GioeleFalbo/Robocassano27/README.md

```text
  .-=================================================================================-.
  |                                                                                   |
  |      ____  ____  ____  ____  _________   __________ ___    _   ______ ___  _____  |
  |     / __ \/ __ \/ __ )/ __ \/ ____/   | / ___/ ___//   |  / | / / __ \__ \/__  /  |
  |    / /_/ / / / / __  / / / / /   / /| | \__ \\__ \/ /| | /  |/ / / / /_/ /  / /   |
  |   / _, _/ /_/ / /_/ / /_/ / /___/ ___ |___/ /__/ / ___ |/ /|  / /_/ / __/  / /    |
  |  /_/ |_|\____/_____/\____/\____/_/  |_/____/____/_/  |_/_/ |_/\____/____/ /_/     |
  |                                                                                   |
  |        -=[  RoboCup Junior  :::  Rescue Line  :::  Cassano allo Ionio  ]=-        |
  |                                                                                   |
  |       [ ClaudeRob V45 ]     [ 111 FIX ]     [ una scatola nera alla volta ]       |
  `-=================================================================================-'
```

<p align="center">
  RoboCassano – RoboCup Junior Rescue Line
</p>

<p align="center">
  
  
  
  
  
  
</p>

<p align="center">
  <b>Un robot che segue la linea, supera ostacoli, rampe e altalena, entra nella zona di evacuazione,<br>
  porta in salvo le vittime e trova l'uscita. Da solo.</b>
</p>

---

## 🤖 Il robot

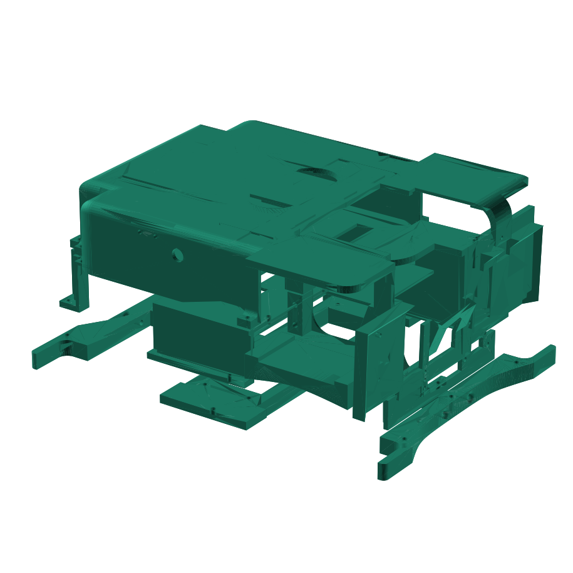
[picture p1: immagini/robot_3d.png]
Il robot RoboCassano in 3D


| | |
|---|---|
| **Cervello** | Raspberry Pi 5 |
| **Occhi** | 2 camere (linea + arena) con reti neurali **YOLO** |
| **Sensi** | Arduino Nano con 3 laser **VL53L1X**, giroscopio **BNO055**, switch |
| **Gambe** | 4 servo Feetech FS5106R a rotazione continua, uno per ruota |
| **Mani** | braccio con servo DM996 e pinza per le vittime (palline argento e nera) |
| **Misure** | 15,6 cm di larghezza, ~20 cm di lunghezza |
| **Memoria** | una **scatola nera** che registra tutto, 10 volte al secondo |
| **Corpo** | pezzi stampati in 3D su tre livelli ([`Meccanica_STL/`](Meccanica_STL/)) |
| **Energia** | LiPo 3S 11,1 V 2200 mAh e 3 convertitori buck |

<br clear="right">

<p align="center">
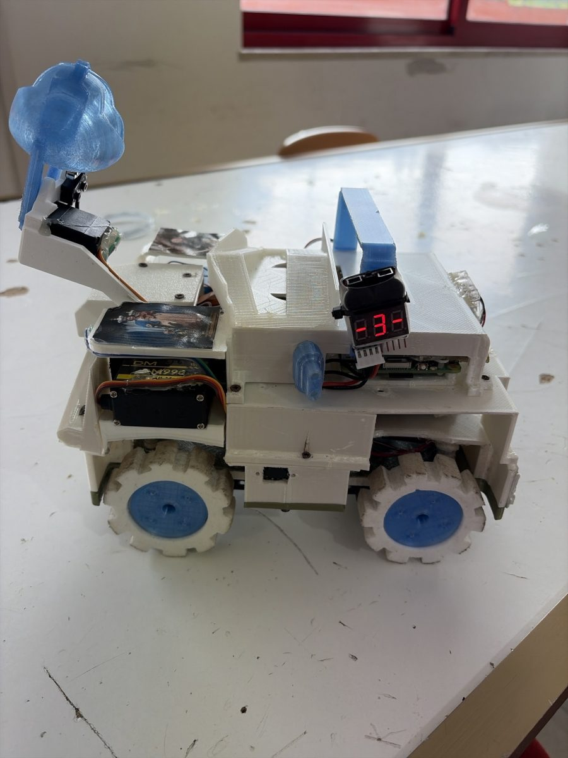
[picture p2: immagini/foto_robot/fianco.jpg]
Il robot RoboCassano visto di fianco
  
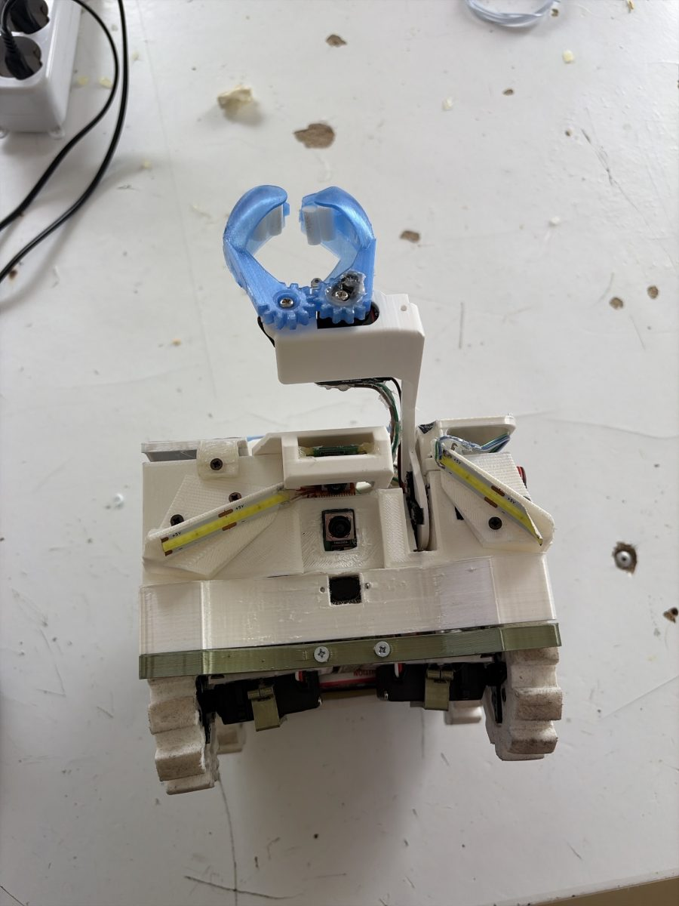
[picture p3: immagini/foto_robot/davanti_pinza.jpg]
Il robot RoboCassano visto da davanti, con la pinza
  
</p>

## 🏁 Una gara, dall'inizio alla fine

```mermaid
flowchart LR
    A([Partenza]) --> B[Seguilinea<br/>verdi, incroci,<br/>ostacolo, rampa]
    B --> C[Ingresso<br/>striscia argento]
    C --> D[Zona di evacuazione<br/>vittime nei triangoli]
    D --> E[Uscita<br/>striscia nera]
    E --> F[Altalena]
    F --> G([Linea rossa:<br/>arrivo!])
```

## 🔬 Il nostro metodo: la scatola nera

Ogni gara vera lascia una **scatola nera**: laser, giroscopio, motori, quello che vede YOLO, le foto delle camere.
Ogni correzione nasce da lì, mai da un'idea a caso:

```mermaid
flowchart LR
    R[🤖 Gara vera] --> S[📦 Scatola nera]
    S --> C[🔍 Causa fisica<br/>secondo per secondo]
    C --> M[🖥️ Riprodotta nel<br/>simulatore]
    M --> F[🛠️ Correzione<br/>FIX n]
    F --> P[✅ Prova prima/dopo]
    P --> R
```

Dal primo programma della squadra a oggi: **111 correzioni** (FIX), ognuna con il suo perché, raccontate nel
[`CHANGELOG`](ClaudeRob_V45/CHANGELOG.md).

## 👥 La squadra

| | Chi | Ruolo |
|---|---|---|
| 🧑‍🏫 | **Prof. Giovanni Vaccaro** | capo squadra: decide, controlla, approva |
| 👨‍🎓 | **Battista** | programmatore, ex modder in HEX, compositore musicale e DJ house. Gestisce la parte del seguilinea e altalena. P.s rimane sempre un tipo retro in tutto  |
| 👨‍🎓 | **Gioele** | zona di evacuazione: ingresso, vittime, uscita |
| 🛠️ | **Gabriel** | il tuttofare: disegno 3D, elettronica e meccanica del robot. Se un pezzo esiste, probabilmente l'ha disegnato, saldato o avvitato lui |
| 🚜 | **Antonio** | l'assemblatore: monta e smonta il robot con metodi da officina di campagna. Non conosce la parola "delicato", ma i pezzi alla fine stanno su. Il suo motto: *"se un pezzo non entra, non è il pezzo sbagliato: è che non hai spinto abbastanza"* |
| 📂 | **Giuseppe** | il custode delle "carte": iscrizioni, documenti di gara e tutto quello che va consegnato in ordine e in tempo |
| 🧠 | **Claude** | l'ingegnere del software: propone e prova le correzioni |
| 🔧 | **Shuri** | il collaudo: prova ogni versione e analizza le scatole nere ([chi è](Laboratorio%20Shuri/CHI_E_SHURI.md)) |

Lavoriamo con persone e agenti di intelligenza artificiale insieme, ma con una regola:
**il robot è nostro, e ogni modifica la deve saper spiegare chi la propone.**

## 📈 Sul campo

| Data | Versione | Com'è andata |
|---|---|---|
| 5 novembre 2026 | V36 | percorso completo, arrivo a 429 s |
| 6 novembre 2026 | V38 | percorso completo, arrivo a **376 s**, **3 vittime su 3**, altalena superata |
| 9 novembre 2026 | **V40** | percorso completo, arrivo a 388 s, **3 vittime su 3**, uscita in 64 s, altalena superata |
| 12 novembre 2026 | V43 | percorso completo, **3 vittime su 3**, uscita in 10 s, arrivo a 547 s (8 LoP nel seguilinea) |
| prossima prova | **V45** | 🔜 ingresso senza retromarce, cabina di pilotaggio nel terminale, una scatola nera per run |

Nel simulatore V32 la V41 completa la **pista della scuola a piastrelle** (ponte, tunnel, altalena) con 6 semi su 6 (262-311 s, 5 senza LoP) e i campi RoboCup di prova.

## 📁 Cosa c'è qui

| Cartella | Cosa c'è |
|---|---|
| [`ClaudeRob_V45/`](ClaudeRob_V45/) | il codice del robot (ultima versione). Sul Raspberry parte da solo da `~/ClaudeRob_GARA` |
| [`ClaudeRob_V44/`](ClaudeRob_V44/), [`ClaudeRob_V43/`](ClaudeRob_V43/), [`ClaudeRob_V42/`](ClaudeRob_V42/), [`ClaudeRob_V41/`](ClaudeRob_V41/), [`ClaudeRob_V40/`](ClaudeRob_V40/), [`ClaudeRob_V39/`](ClaudeRob_V39/) | le versioni precedenti, tenute per i confronti nel simulatore |
| [`ClaudeRob_Simulatore_V32/`](ClaudeRob_Simulatore_V32/) | il simulatore (Python 3 + `numpy` + `opencv-python`), con la pista della scuola **a piastrelle**: ponte sopra il tunnel, rampe di 21°, altalena, luci e ombre, cono vero del laser ([mappa](ClaudeRob_Simulatore_V32/mappa_scuola.png)) |
| [`ClaudeRob_Simulatore_V31/`](ClaudeRob_Simulatore_V31/) | il simulatore precedente, tenuto per i confronti |
| [`Strumenti_prove_Claude/`](Strumenti_prove_Claude/) | prove automatiche di porte e altalena nel simulatore |
| [`Laboratorio Shuri/`](Laboratorio%20Shuri/) | gli strumenti di Shuri: batteria di prove, analisi delle scatole nere, ultimo rapporto |
| [`ScatoleNere/`](ScatoleNere/) | le scatole nere delle gare vere e la foto dell'arena dall'alto |
| [`Meccanica_STL/`](Meccanica_STL/) | i pezzi stampati in 3D del robot (millimetri), compreso il braccio, e **`esploso_robot.html`**: il robot in 3D che si smonta (doppio clic) |
| [`Meccanica_STL/componenti/`](Meccanica_STL/componenti/) | i componenti in 3D semplificato: servo FS5106R e DM996, LiPo, buck, Arduino Nano, PCA9685, Raspberry Pi 5, relè |
| [`immagini/`](immagini/) | il banner, il robot in 3D e le [foto del robot vero](immagini/foto_robot/) |
| [`.claude/skills/anatomia/`](.claude/skills/anatomia/) | la skill **anatomia**: chiedete a Claude *"smontami il sistema dei laser"* e vi spiega ogni pezzo, nel robot e nel codice |
| [`COME_LAVORARE.md`](COME_LAVORARE.md) | **per chi entra nella squadra**: GitHub, regole delle versioni, prove nel simulatore |
| [`CLAUDE.md`](CLAUDE.md) | regole del progetto, storia delle versioni e cose da fare (lo legge Claude Code) |
| [`Raspberry/`](Raspberry/) | l'avvio del robot: all'accensione parte da solo con l'ultima versione copiata sul Raspberry |
| `Aggiorna da GitHub.command` | doppio clic sul Mac: aggiorna la cartella `02_Robotica` con l'ultima versione |

## 🚀 Provare il robot nel simulatore

```
pip3 install numpy opencv-python
cd Strumenti_prove_Claude
python3 gira.py ../ClaudeRob_V45 prova scuola_nuova 480 seme=1
```

E per vederlo muoversi nel browser:

```
cd ../ClaudeRob_Simulatore_V32
python3 crea_replay.py prova.html replay_prova.json:"Prova V45"
```

---

<p align="center">
  <sub>Fatto a Cassano allo Ionio, una scatola nera alla volta. 🖤🟩</sub>
</p>
