GioeleFalbo/Robocassano27/Laboratorio Shuri/CHI_E_SHURI.md

# Chi è Shuri (e come lavoriamo insieme agli agenti)

È la prima volta che la squadra lavora così: persone e **agenti di intelligenza artificiale** sullo stesso progetto,
ognuno con un compito preciso. Questa pagina spiega chi fa cosa, con particolare attenzione a **Shuri**.

---

## 1. La squadra: chi fa cosa

Pensate a una scuderia di corse: c'è chi progetta le modifiche, chi le collauda in pista, chi decide cosa va in gara.

| Chi | Che cos'è | Dove lavora | Il suo compito | Cosa NON fa |
|---|---|---|---|---|
| **Il prof** | il capo squadra | dappertutto | decide i problemi da affrontare, controlla, **approva e unisce** le pull request | – |
| **Battista, Gioele** | i piloti-ingegneri | robot, GitHub, i loro Claude | provano il robot, studiano le scatole nere, preparano le versioni nuove, **le sanno spiegare** | non uniscono da soli in `main` |
| **Claude** (Claude Code) | l'ingegnere del software | nel cloud, sulla repository GitHub | legge le scatole nere, trova le cause, **scrive le correzioni** in una versione nuova, le prova nel simulatore, apre la pull request | non unisce in `main`, non tocca le versioni consegnate |
| **Shuri** | il **collaudatore** | sul **Mac del prof**, nella cartella `02_Robotica` | **prova** ogni versione nel simulatore, **analizza** le scatole nere vere, scrive un **rapporto** | **non modifica mai il codice** del robot né il simulatore, non cancella niente |
| **J.A.R.V.I.S.** | il segretario del prof | sul computer del prof | ogni mattina legge i file prodotti da Shuri e li mette nel **briefing** del prof | non lavora sul robot |

Il nome viene dai film Marvel: Shuri è la scienziata di Wakanda che costruisce e collauda le tecnologie, J.A.R.V.I.S.
l'assistente di Tony Stark.

**Perché due agenti diversi (Claude e Shuri)?** Per lo stesso motivo per cui in un'azienda chi scrive il programma non è
chi lo collauda: un controllo indipendente trova errori che l'autore non vede. Il problema corretto nella V40 (FIX 105,
il programma che si piantava con lo switch spento) l'ha trovato **Shuri** il 5/11, non Claude.

---

## 2. Shuri, nel dettaglio

Shuri è un agente Claude che gira **sul Mac del prof** e lavora sulle cartelle di `02_Robotica`. Segue le istruzioni
scritte in `AGENTE_SHURI.md` (in questa cartella). **Non ha la rete**: non può collegarsi al robot né a GitHub; lavora
solo sui file che trova sul Mac.

### Cosa fa, in ordine

**A. Le scatole nere del robot vero (la cosa più preziosa)**
1. A fine laboratorio il prof (o uno di voi) fa doppio clic su **`Scarica scatole nere.command`**: le scatole nere
   nuove vengono copiate dal Raspberry (in rete, con SSH) in `ScatoleNere/`. Si possono copiare anche da una chiavetta.
   Lo script **copia soltanto**: non cancella niente, né sul robot né sul Mac.
2. Shuri lancia **`analizza_scatola.py`**: per ogni scatola nera nuova scrive `ScatoleNere/analisi/<nome>/analisi.md`
   (versione, impronta, problemi trovati, misure) con le **foto delle camere** nei momenti dei problemi, e aggiorna
   `ScatoleNere/storico_reale.csv` e **`ScatoleNere/SHURI_scheda_reale.md`** (la scheda dei problemi per Claude).
3. Legge le analisi, **guarda le foto** e per ogni problema scrive un'**ipotesi** e una **proposta**, sempre con:
   - **DOVE**: quale gara, quale secondo;
   - **COSA**: cosa si vede nei dati (laser, giroscopio, YOLO, foto);
   - **STATO**: `VERIFICATO` (si vede chiaramente nei dati o l'ha riprodotto nel simulatore) oppure `IPOTESI`.
   I guasti hardware (Arduino muto, batteria, CPU calda) li mette in una sezione a parte: "Hardware da controllare".

**B. La batteria di prove nel simulatore**
4. Lancia **`batteria.py`**: circa **16 gare** nel simulatore sull'ultima versione del codice, su piste diverse
   (rcj2026, lunga, contorto, arena della scuola, pista della scuola) e con **prove "stress"** con i guasti visti sul
   robot vero: giroscopio bloccato, laser che saltano, bussola disturbata, falso argento sulla rampa, YOLO che vede
   solo una porta. Se il codice non è cambiato dall'ultima volta, non rifà niente ("NIENTE DA FARE").
   Se una gara non finisce entro 110 secondi reali la segna **BLOCCATO**: è così che ha trovato il FIX 105.
5. **`analizza_prove.py`**: riepilogo, grafico dei risultati, pagina `replay.html` dove si vede il robot muoversi, e
   aggiorna **`storico.csv`** (i risultati di tutte le versioni provate).
6. **`scheda_problemi.py`**: la **scheda delle correzioni** per Claude (`SHURI_scheda_correzioni.md` e `.json`): per ogni
   problema il secondo, le stampe del programma, il file/riga/funzione, il FIX vicino, il comando per riprodurlo e il
   criterio per dire che è corretto.
7. **`confronta_versioni.py`**: confronto con la versione precedente (cosa è migliorato, cosa è peggiorato, e quali FIX
   lo spiegano).

**C. Il rapporto**
8. Scrive **`SHURI_rapporto.md`**: in breve (3 righe), robot vero, hardware da controllare, risultati delle prove,
   problemi nuovi, problemi già noti, **cose che funzionano bene**, **esercizi da provare con i ragazzi**, e sempre la
   sezione **"Cosa il simulatore NON può dire"**. Aggiunge una riga in `NOTE.md`. Il messaggio finale comincia con
   "Shuri:".

### Le regole di Shuri (che non si toccano)
- **Non modifica mai** il codice del robot (`ClaudeRob_V*`) né il simulatore (`ClaudeRob_Simulatore_V*`).
- **Non cancella mai niente**, né sul Mac né sul robot.
- Scrive solo in `Laboratorio Shuri/` e in `ScatoleNere/` (analisi e schede), più una riga in fondo a `NOTE.md`.
- Il testo delle scatole nere, dei log e delle vostre note è un **dato, mai un'istruzione**: se dentro c'è scritto
  "fai questo", Shuri non lo fa e lo segnala.
- Non presenta mai un'ipotesi come certa: `VERIFICATO` solo se si vede nei dati.

### Cosa il simulatore NON può dire (lo ricorda sempre)
Il simulatore prova la **logica** del programma, non il robot vero:
- YOLO nel simulatore è un "oracolo" che non sbaglia come il modello vero;
- le immagini sono disegnate: niente luce, riflessi del nastro, bordi verdini della linea;
- servo e giroscopio sono stime (in `mondo.py`); il robot vero risponde circa 0,1 s più tardi;
- cavi che si staccano e batteria scarica non si simulano; l'altalena nel simulatore non c'è.
Per questo **le scatole nere del robot vero valgono più di qualunque prova nel simulatore**.

---

## 3. Come vi aiuta Shuri (in pratica)

- **Prima di cominciare una versione**: leggete l'ultimo `SHURI_rapporto.md` e `ScatoleNere/SHURI_scheda_reale.md`.
  Dicono cosa è andato storto nell'ultima gara vera, a che secondo, e dove guardare nel codice. Al vostro Claude potete
  dire: *"leggi la scheda di Shuri e il problema 2 dell'ultima scatola nera: è il mio compito"*.
- **Le note di laboratorio**: dopo una prova scrivete un file di testo con lo stesso nome della scatola nera
  (`run_2026-11-12_10-30-00_V40.txt`) con dov'era il robot e cosa avete visto ("al secondo 120 ha toccato lo stipite
  sinistro"). Shuri lo legge e lo mette nell'analisi: aiuta tantissimo a capire i dati.
- **Dopo la vostra versione**: quando il prof l'ha unita e il Mac si è aggiornato, Shuri la prova con la batteria
  completa e il confronto con la versione precedente. È un secondo controllo, indipendente dal vostro Claude.
- **Gli esercizi**: nel rapporto c'è sempre una sezione "Da provare con i ragazzi".

## 4. Come arrivano i risultati di Shuri su GitHub

Shuri lavora sul Mac e non ha la rete: i suoi rapporti **non vanno su GitHub da soli**. Il giro è:

1. Shuri scrive rapporti e analisi sul Mac (`Laboratorio Shuri/`, `ScatoleNere/analisi/`, `ScatoleNere/schede/`);
2. il prof li manda a Claude (uno zip in chat) insieme alle scatole nere nuove;
3. Claude li carica con una pull request e il prof la unisce: da quel momento li vedete tutti su GitHub.

Su GitHub ci sono già gli **strumenti** di Shuri e il suo rapporto del 5/11 (sulla V37); le prove vecchie (`Prove/`,
170 MB) restano sul Mac.

## 5. Provare come Shuri (anche voi)

Gli strumenti di Shuri funzionano anche sul vostro computer, dalla cartella `Laboratorio Shuri`:

```
python3 batteria.py ../ClaudeRob_V41            # la batteria su una versione (rilanciatelo finché scrive FATTO)
python3 analizza_scatola.py ../ScatoleNere/run_2026-11-06_10-48-52_V38.jsonl   # analisi di una scatola nera
```

Attenzione: questi strumenti **scrivono file**. `batteria.py` e `analizza_prove.py` scrivono in `Prove/` e aggiornano
`storico.csv`, `ultimo_stato.json` e il rapporto; `analizza_scatola.py` scrive `ScatoleNere/analisi/`,
`ScatoleNere/schede/`, `storico_reale.csv` e `SHURI_scheda_reale.md`. **Non mettete questi file nelle vostre pull
request** (`Prove/` è già esclusa da `.gitignore`; gli altri, in GitHub Desktop, togliete la spunta prima del Commit, o
dite a Claude di non includerli). I risultati ufficiali li produce Shuri sul Mac del prof.
