GioeleFalbo/Robocassano27/ClaudeRob_Simulatore_V32/mappa_scuola.png

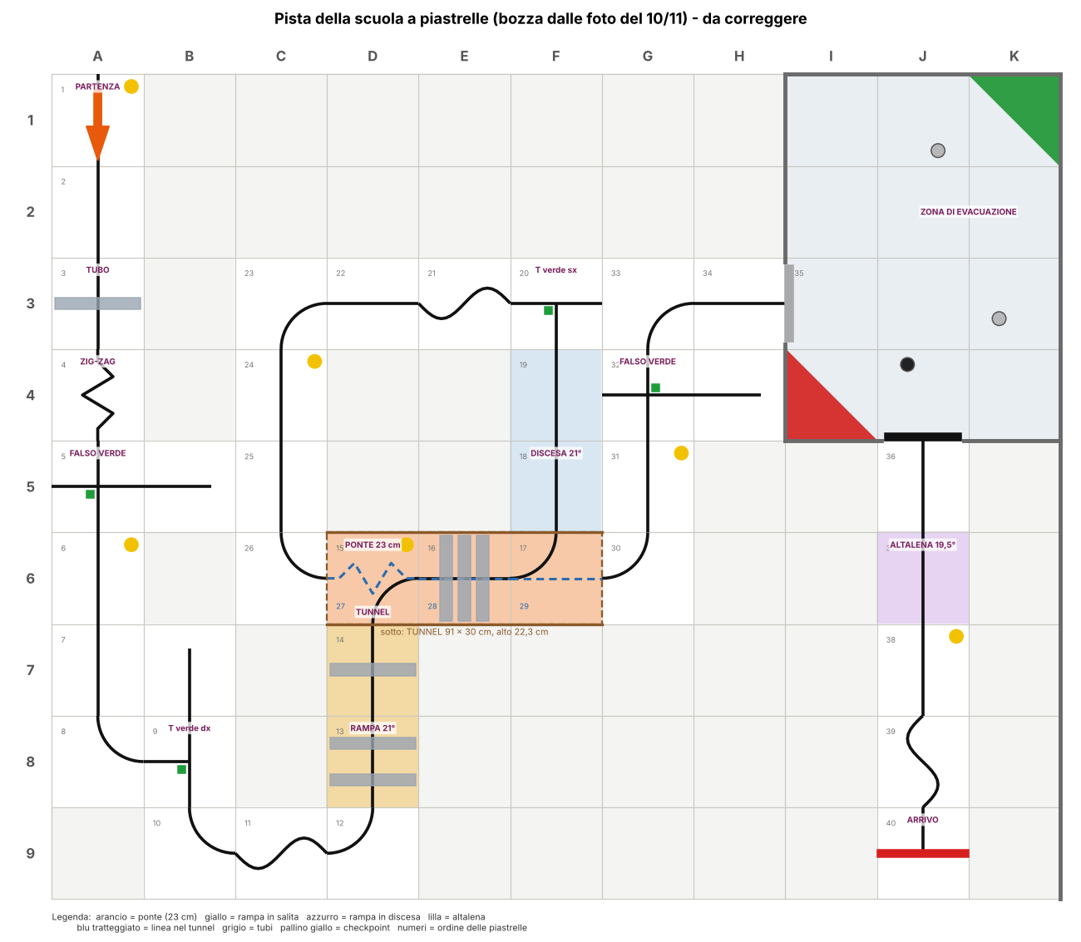
ClaudeRob_Simulatore_V32/mappa_scuola.png
