GioeleFalbo/Robocassano27/immagini/foto_robot/fianco_elettronica.jpg

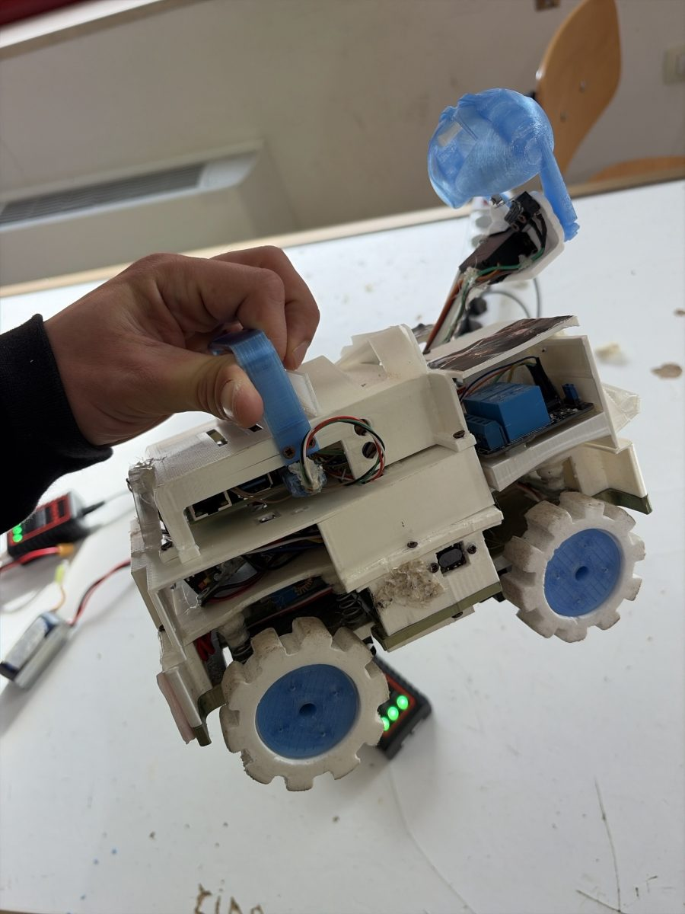
immagini/foto_robot/fianco_elettronica.jpg
