GioeleFalbo/Robocassano27/immagini/foto_robot/sotto.jpg

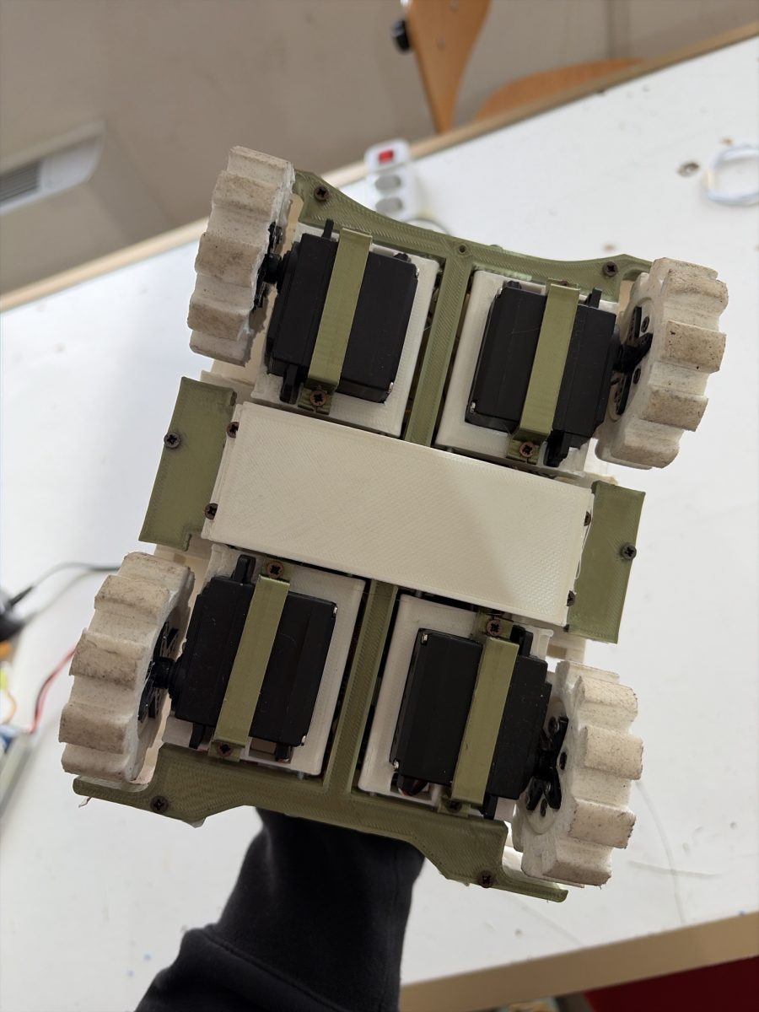
immagini/foto_robot/sotto.jpg
