GioeleFalbo/Robocassano27/ScatoleNere/arena_dall_alto_2026-11-05.jpg

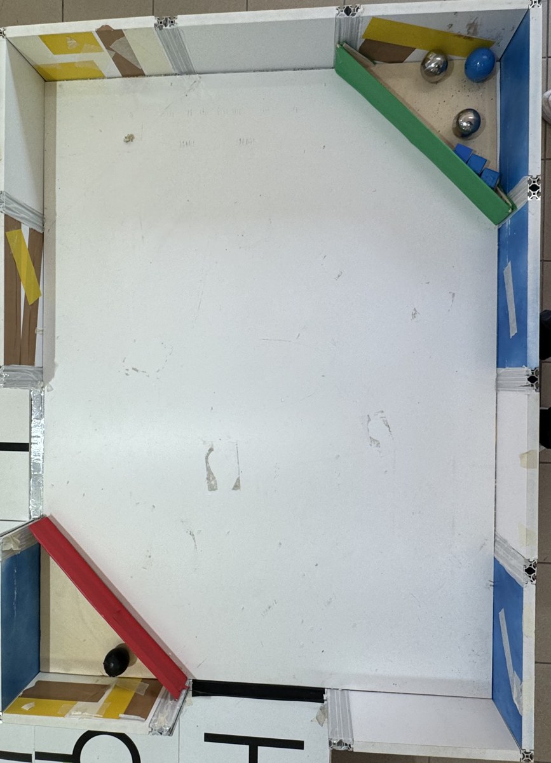
ScatoleNere/arena_dall_alto_2026-11-05.jpg
