GioeleFalbo/Robocassano27/ClaudeRob_V45/cruscotto/robot.stl

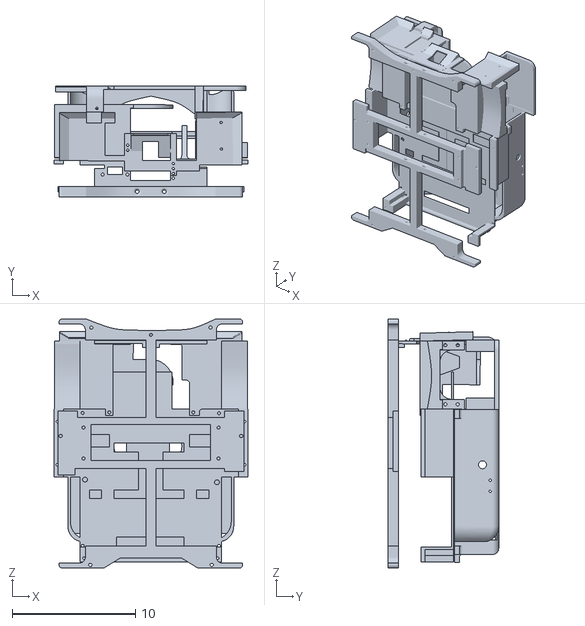
[picture p8: CAD file, 2026-11-08]
ClaudeRob_V45/cruscotto/robot.stl
15.7 x 8.96 x 20.2
