GioeleFalbo/Robocassano27/Meccanica_STL/BiSwitch.stl

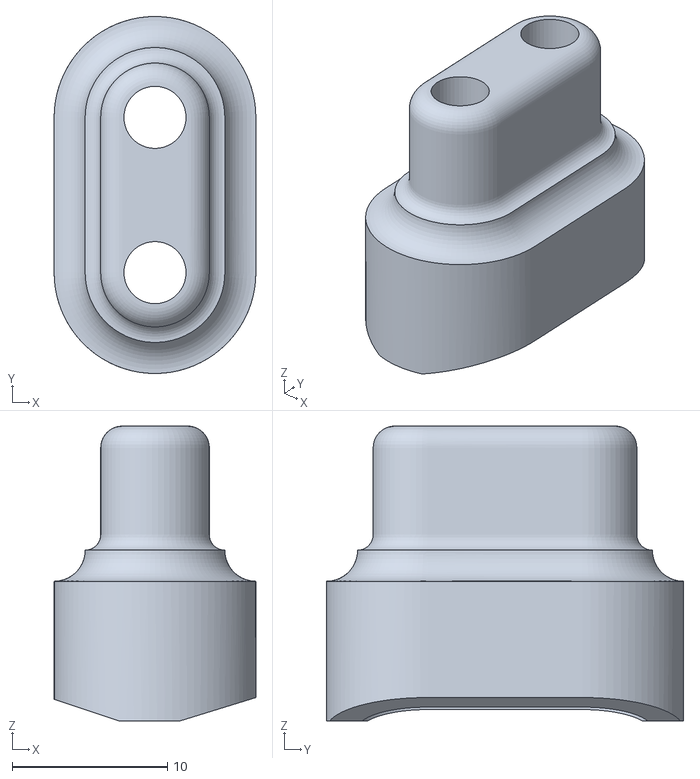
[picture p9: CAD file, 2026-11-12]
Meccanica_STL/BiSwitch.stl
13.0 x 23.0 x 19.0
