GioeleFalbo/Robocassano27/Meccanica_STL/componenti/Raspberry_Pi_5.stl

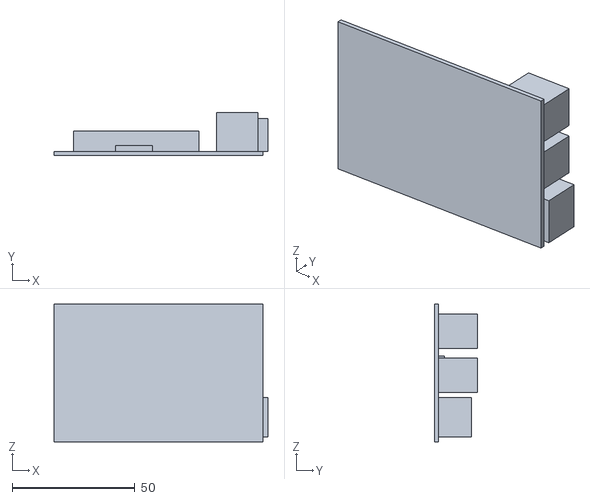
[picture p10: CAD file, 2026-11-10]
Meccanica_STL/componenti/Raspberry_Pi_5.stl
87.0 x 17.6 x 56.0
