GioeleFalbo/Robocassano27/Meccanica_STL/componenti/LiPo_Zeee_3S_2200.stl

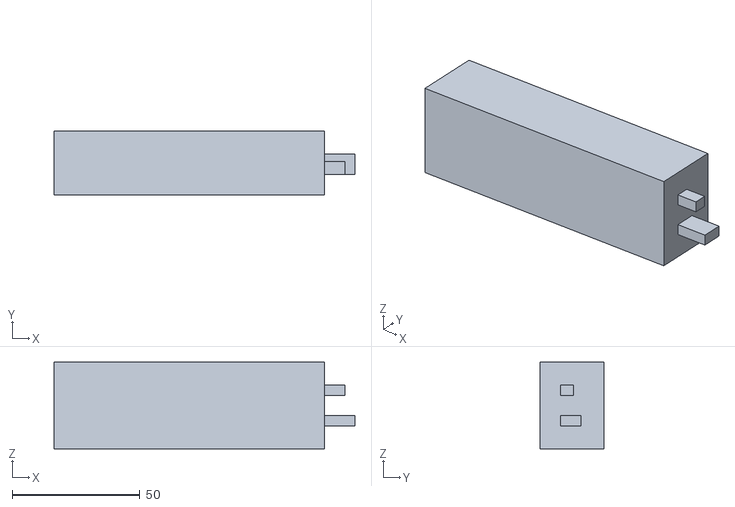
[picture p11: CAD file, 2026-11-10]
Meccanica_STL/componenti/LiPo_Zeee_3S_2200.stl
118.0 x 25.0 x 34.0
