GioeleFalbo/Robocassano27/Meccanica_STL/PinzaParteDxSfera.stl

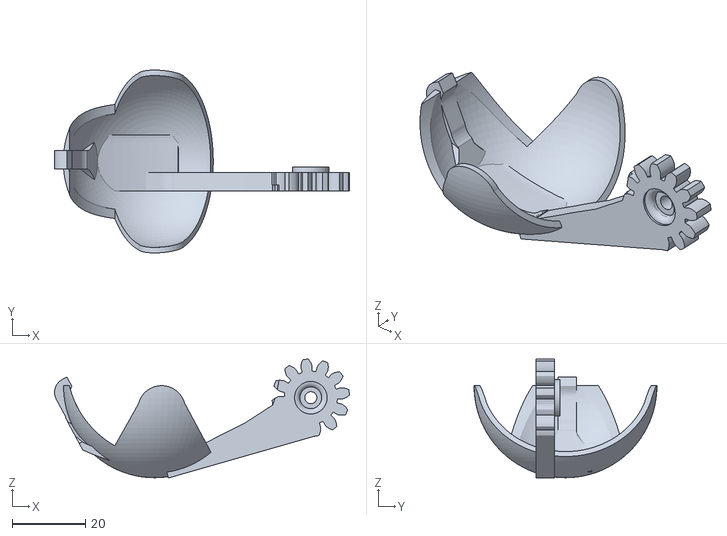
[picture p12: CAD file, 2026-11-12]
Meccanica_STL/PinzaParteDxSfera.stl
80.7 x 50.0 x 32.5
