GioeleFalbo/Robocassano27/Meccanica_STL/componenti/PCA9685_16canali.stl

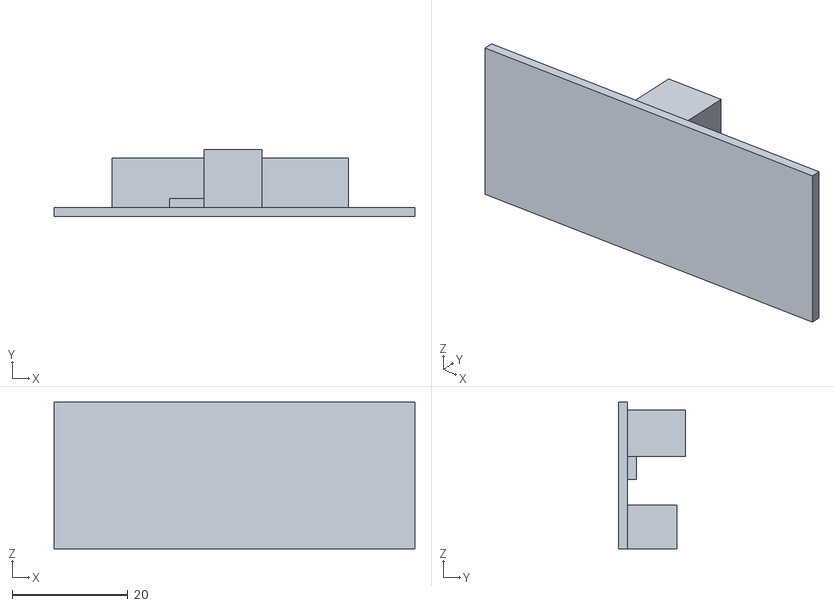
[picture p13: CAD file, 2026-11-10]
Meccanica_STL/componenti/PCA9685_16canali.stl
62.5 x 11.6 x 25.4
