GioeleFalbo/Robocassano27/Meccanica_STL/PinzaParteSxSfera.stl

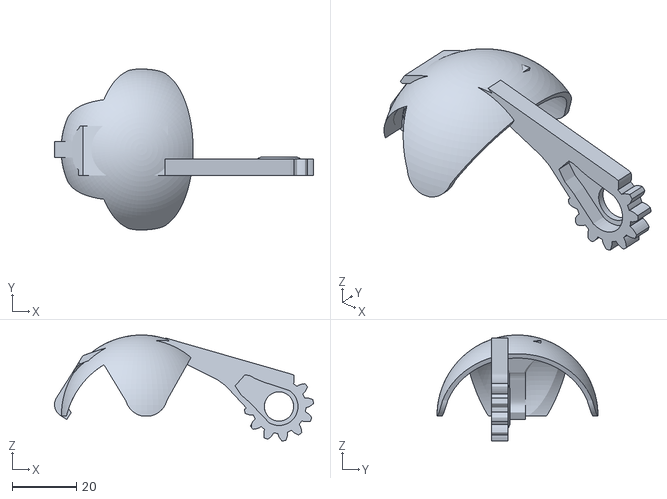
[picture p14: CAD file, 2026-11-12]
Meccanica_STL/PinzaParteSxSfera.stl
80.4 x 50.0 x 32.9
