GioeleFalbo/Robocassano27/Meccanica_STL/Braccio.stl

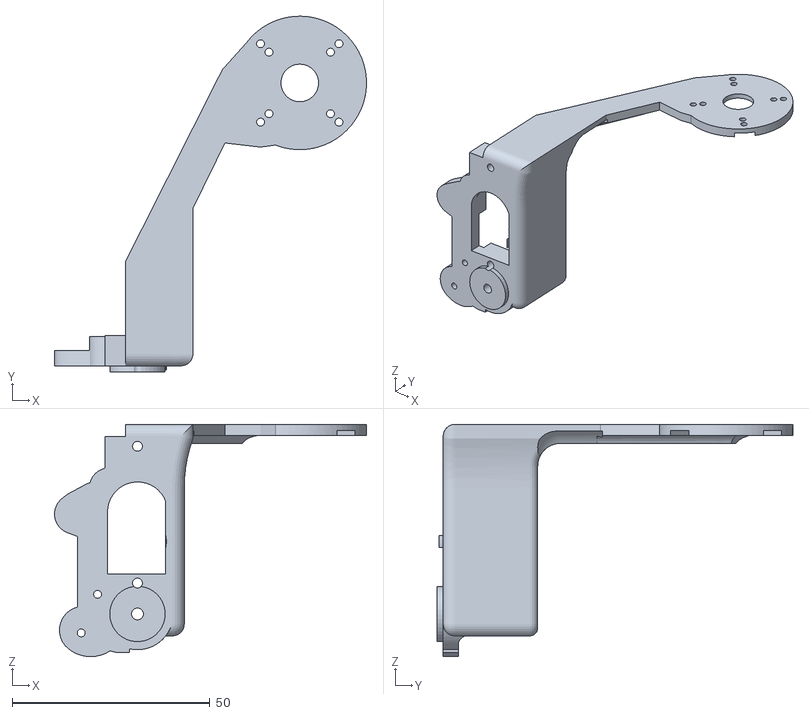
[picture p15: CAD file, 2026-11-10]
Meccanica_STL/Braccio.stl
78.8 x 89.8 x 58.7
