GioeleFalbo/Robocassano27/Meccanica_STL/componenti/Rele_2_canali.stl

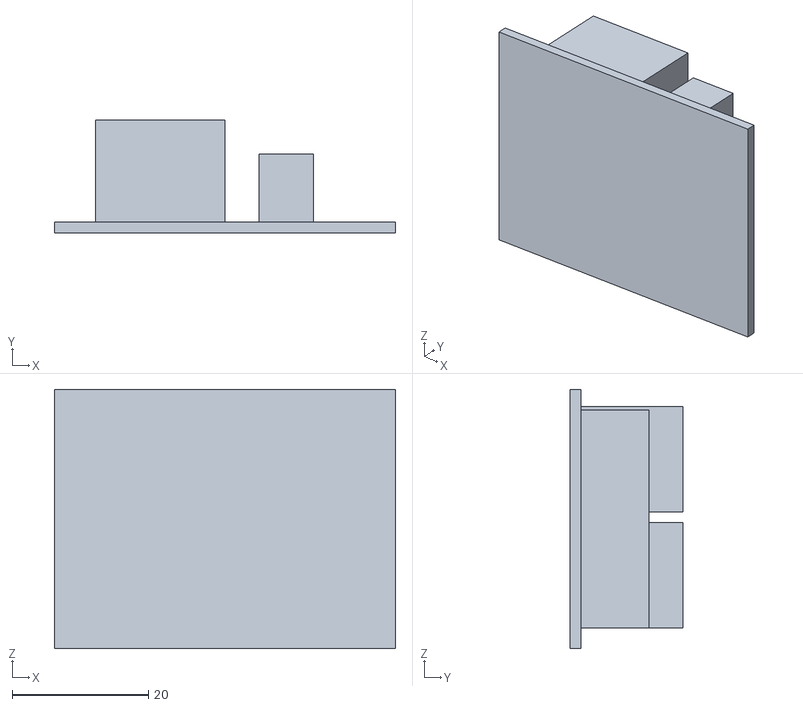
[picture p16: CAD file, 2026-11-10]
Meccanica_STL/componenti/Rele_2_canali.stl
50.0 x 16.6 x 38.0
