GioeleFalbo/Robocassano27/Meccanica_STL/componenti/Servo_DM996.stl

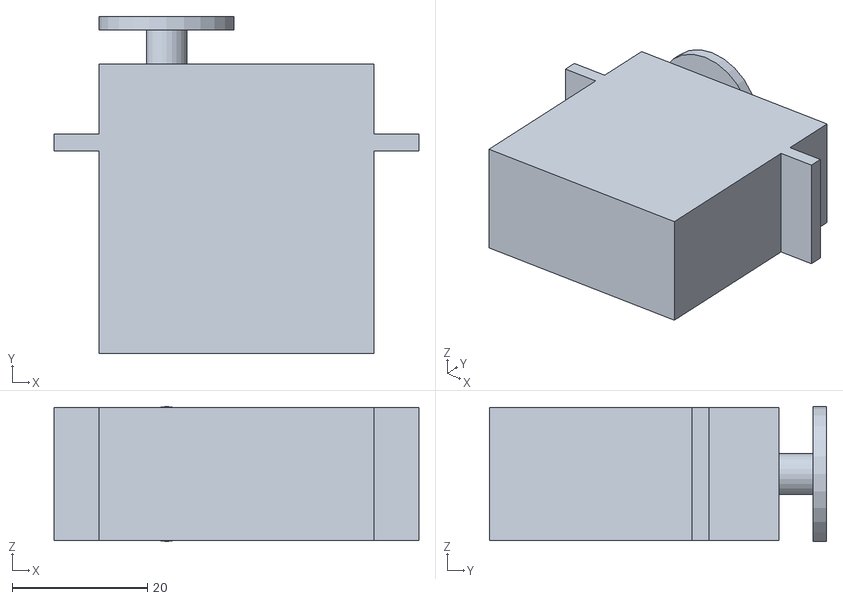
[picture p17: CAD file, 2026-11-10]
Meccanica_STL/componenti/Servo_DM996.stl
54.0 x 49.9 x 20.0
