GioeleFalbo/Robocassano27/Meccanica_STL/SupportoPinzaWebcam_1.stl

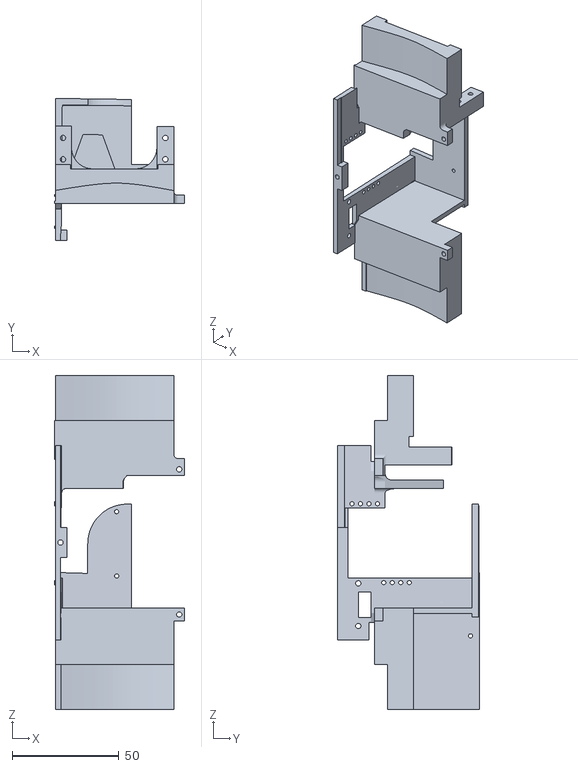
[picture p18: CAD file, 2026-11-08]
Meccanica_STL/SupportoPinzaWebcam_1.stl
61.0 x 66.7 x 156.6
