GioeleFalbo/Robocassano27/Meccanica_STL/componenti/Buck_DCDC.stl

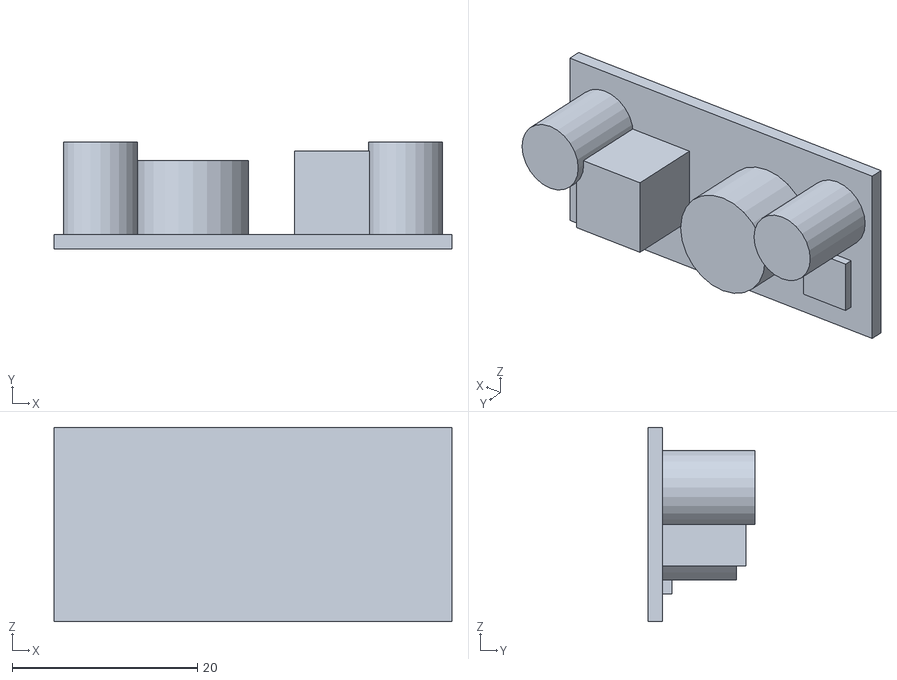
[picture p19: CAD file, 2026-11-10]
Meccanica_STL/componenti/Buck_DCDC.stl
43.0 x 11.6 x 21.0
