GioeleFalbo/Robocassano27/Meccanica_STL/CoperturaAlta.stl

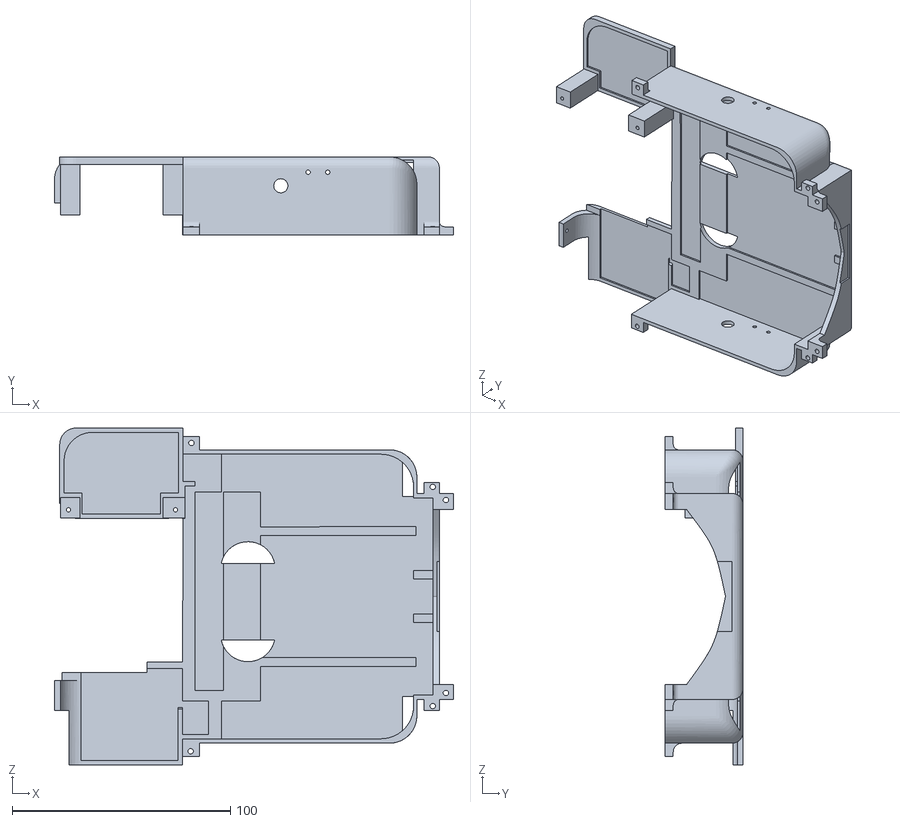
[picture p20: CAD file, 2026-11-08]
Meccanica_STL/CoperturaAlta.stl
182.9 x 35.8 x 154.4
