GioeleFalbo/Robocassano27/Meccanica_STL/componenti/Servo_FS5106R.stl

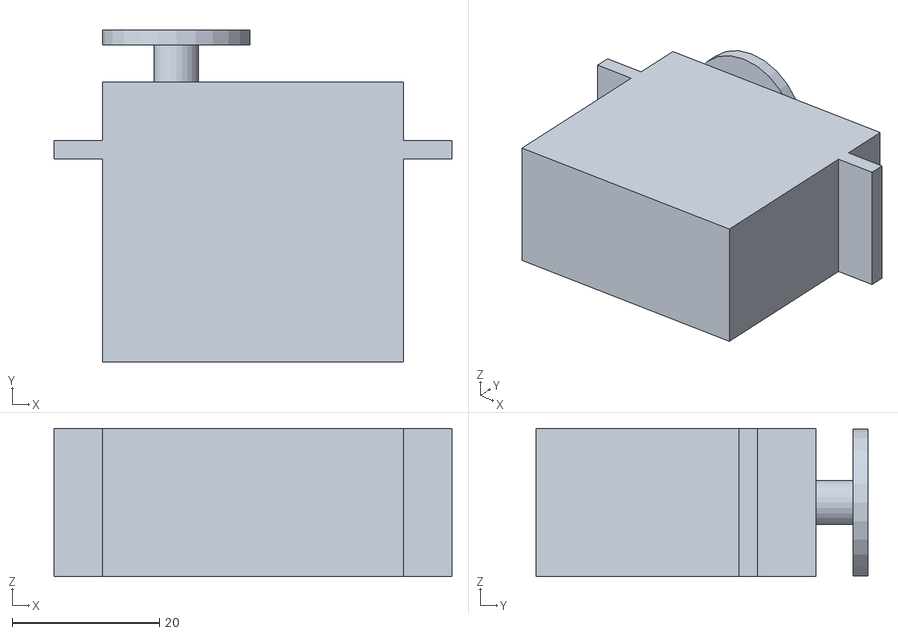
[picture p21: CAD file, 2026-11-10]
Meccanica_STL/componenti/Servo_FS5106R.stl
54.0 x 45.0 x 20.1
