GioeleFalbo/Robocassano27/Meccanica_STL/ServoRWDAmmortizzato.stl

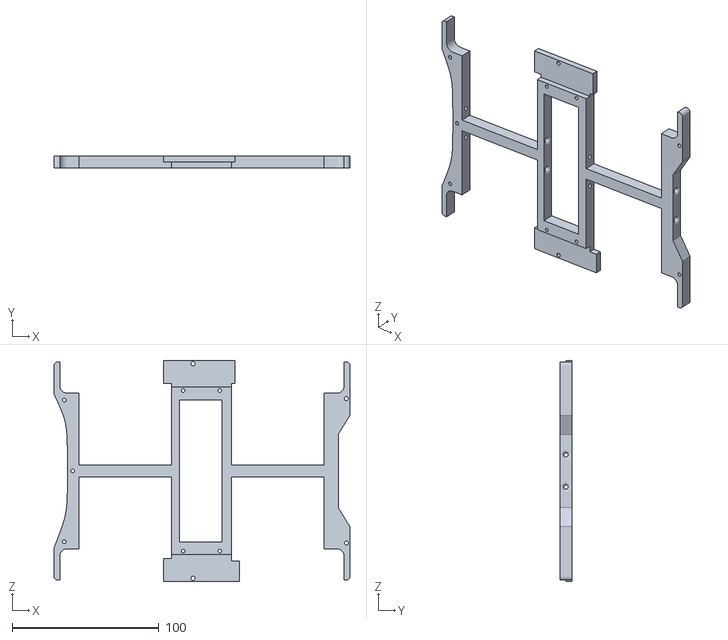
[picture p22: CAD file, 2026-11-08]
Meccanica_STL/ServoRWDAmmortizzato.stl
201.8 x 8.25 x 150.9
