GioeleFalbo/Robocassano27/Meccanica_STL/componenti/Arduino_Nano.stl

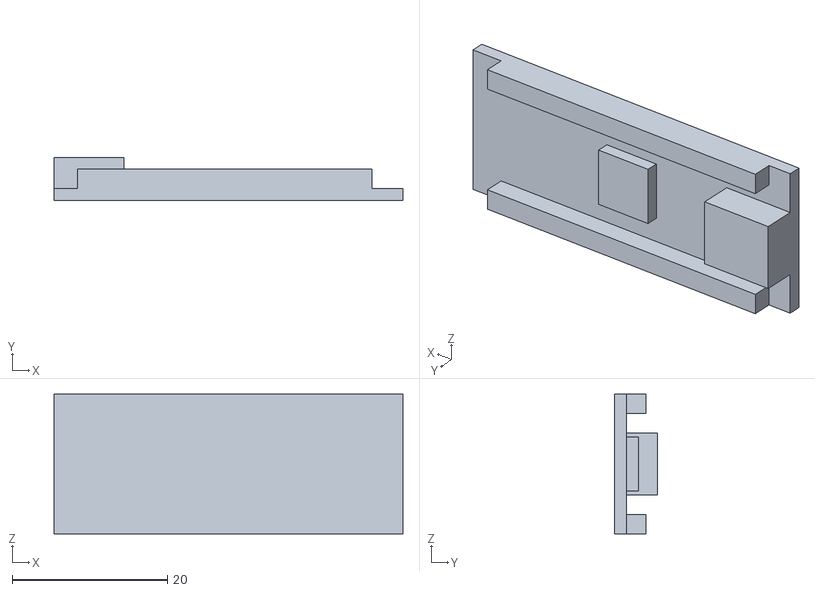
[picture p23: CAD file, 2026-11-10]
Meccanica_STL/componenti/Arduino_Nano.stl
45.0 x 5.60 x 18.0
