GioeleFalbo/Robocassano27/Meccanica_STL/CupolaWebArenaLED.stl

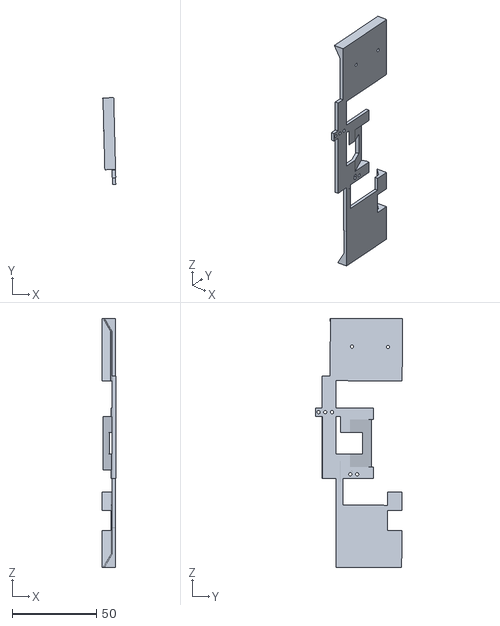
[picture p24: CAD file, 2026-11-08]
Meccanica_STL/CupolaWebArenaLED.stl
8.08 x 51.6 x 148.1
