GioeleFalbo/Robocassano27/Meccanica_STL/BaseLogica.stl

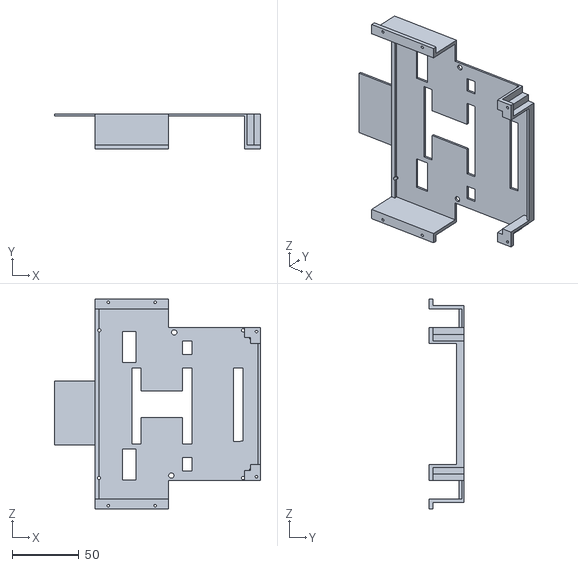
[picture p25: CAD file, 2026-11-08]
Meccanica_STL/BaseLogica.stl
154.0 x 26.0 x 156.9
