GioeleFalbo/Robocassano27/(commit log)

2026-11-08 Struttura iniziale: V39, simulatore V31, strumenti, Shuri, STL
    Claude-Session: https://claude.ai/code/session_011m7nZYVzzK7VxgaVHLn5r8
    [BaseLogica.stl, CoperturaAlta.stl, CupolaWebArenaLED.stl, ServoRWDAmmortizzato.stl, SupportoPinzaWebcam_1.stl, robot.stl, storico.csv]
2026-11-08 V40: FIX 105 switch spento durante il controllo di un'apertura
    Rapporto di Shuri del 5/11 (stress_guasti_reali): con lo switch spento
    (LoP) Dritto usciva subito e il ciclo di misura in ControllaAperturaMuro
    girava a vuoto, il programma si piantava. Ora ControllaAperturaMuro esce
    subito (SwitchSpento) e Dritto a switch spento ferma i motori e aspetta
    0,1 s. Simulatore V31: 0 blocchi su 74 prove con lo switch spento (V39: 1),
    gare normali identiche alla V39. Aggiornati CHANGELOG, LEGGIMI_MODIFICHE,
    CLAUDE.md e README.
    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
    [robot.stl]
2026-11-08 Script "Aggiorna da GitHub.command" per il Mac
    Doppio clic: scarica da GitHub il ramo main nella cartella 02_Robotica.
    Solo avanti veloce: se un file è cambiato sia sul Mac sia su GitHub si
    ferma senza sovrascrivere niente.
    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
2026-11-08 Aggiorna da GitHub: sostituisce da solo i file identici già sul Mac
    Se su GitHub arriva un file nuovo che sul Mac c'è già (per esempio una
    scatola nera mandata a Claude) git si rifiutava di aggiornare. Ora, se il
    file è identico, lo script lo lascia sostituire; se è diverso non lo tocca
    e lo dice.
    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
2026-11-08 Gioele nella squadra; versioni prenotate con le issue
    CLAUDE.md: Battista e Gioele collaboratori, main protetto, regola delle
    versioni prenotate con le issue (vale anche per Claude).
    COME_LAVORARE.md: ognuno il suo pezzo di robot, chi apre per primo
    l'issue prende il numero, Update branch dopo il merge di un altro.
    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
2026-11-08 COME_LAVORARE.md: "Prima il robot, poi il codice" e lavorare con Claude Code
    Sezione 0: le tre domande a cui ogni pull request deve saper rispondere a
    voce, e come imparare il Python un pezzo alla volta sul nostro robot.
    Sezione 7: lavorare con Claude Code (account proprio, ramo, una sessione
    per compito, la pull request si sa spiegare).
    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
2026-11-08 Il giro della squadra e "chi arriva secondo si aggiorna"
    COME_LAVORARE.md (sezione 4) e CLAUDE.md: dal robot alla versione nuova,
    scatola nera su GitHub una volta sola, un'issue per pezzo, e come rifare
    una versione preparata in parallelo partendo da quella appena unita.
    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
2026-11-08 Chi è Shuri: scheda per la squadra
    Laboratorio Shuri/CHI_E_SHURI.md: chi fa cosa (prof, ragazzi, Claude,
    Shuri, J.A.R.V.I.S.), cosa fa Shuri passo per passo, le sue regole, cosa
    il simulatore non può dire, come usarlo, come arrivano i suoi rapporti su
    GitHub e come provare i suoi strumenti. Collegata da COME_LAVORARE.md,
    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
2026-11-08 Un po' di personalità: README nuovo, banner, robot 3D, modelli
    - immagini/banner.svg: la pista con la linea, i verdi, l'ingresso argento
    e la zona di evacuazione.
    - immagini/robot_3d.png: il robot disegnato dal suo file STL (cruscotto).
    - README: badge, il robot, una gara in un diagramma, il metodo della
    scatola nera, la squadra, i risultati sul campo, come cominciare.
    - .github/pull_request_template.md: le tre domande e i controlli.
    - .github/ISSUE_TEMPLATE: prenota una versione nuova, problema visto in gara.
    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
2026-11-08 Aggiorna da GitHub senza git dentro iCloud
    02_Robotica sta in iCloud ed è sincronizzata tra i due Mac del prof: git
    dentro iCloud si rovinava (sul MacBook Air "fatal: mmap failed", file
    spostati nel cloud, due Mac che scrivono nella stessa .git). Ora la copia
    di GitHub sta fuori da iCloud (~/.robocassano27_git, una per Mac) e lo
    script copia in 02_Robotica solo i file nuovi o cambiati: non cancella
    niente, non sovrascrive mai i file di Shuri, si ferma se trova ancora .git
    nella cartella, può aggiornare anche sé stesso. Aggiornati CLAUDE.md e
    AGENTE_SHURI.md.
    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
2026-11-09 Robot: cartella pulita V40 e ClaudeRob_GARA (9/11)
    Sul Raspberry la V40 è ora in ~/ClaudeRob_V40 (impronta dcd59068b49486ac
    verificata) con i 4 modelli YOLO; ~/ClaudeRob_GARA è il collegamento alla
    versione di gara e l'avvio automatico lancia ~/ClaudeRob_GARA/avvia.sh.
    CLAUDE.md e COME_LAVORARE.md: come portare una versione nuova sul robot,
    come tornare indietro, niente RwdFoto via SSH, archivio di /home/pi.
    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
2026-11-09 V41: FIX 106 ingresso, niente falsi "non avanzo" con la porta aperta
    Scatola nera 09/11 10:46 (V40), secondi 136-158: robot centrato e dritto,
    laser davanti 101-103 cm, ma dopo 0,6 s "non avanzo" e retromarcia per 4
    volte (48 s persi). A 1 m il laser davanti balla di +-2 cm e il cono vede
    gli stipiti: in 0,6 s non si accorcia anche se il robot avanza. Ora con il
    laser lontano (>= 60 cm) il controllo parte dopo 1,5 s e vuole 5 cm in
    1,2 s; da vicino e "girato da solo" come prima. Nelle 17 scatole nere i 10
    "non avanzo" dell'ingresso erano tutti con il laser lontano. Simulatore:
    tutte le prove identiche alla V40 (gare, ingresso 18/18, uscite, altalena,
    stress, rumore 2 cm). Issue #12.
    Co-Auth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
    [robot.stl]
2026-11-10 Skill "anatomia": smontare il robot sistema per sistema, ed esploso 3D
    .claude/skills/anatomia/: SKILL.md (come rispondere a "smontami X"),
    anatomia.md (mappa, corpo, cervello, occhi, sensi, gambe, mani, luci,
    memoria, comportamenti con funzioni, parametri, campi della scatola nera e
    FIX, verificati sulla V41) e costruisci_esploso.py, che crea
    Meccanica_STL/esploso_robot.html: i 5 pezzi stampati in 3D che si smontano
    con un cursore, con la scheda di ogni pezzo, senza Internet.
    Collegata da README, COME_LAVORARE, CLAUDE.md e LEGGIMI degli STL.
    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
2026-11-10 Anatomia: energia (LiPo 11,1 V, buck DC-DC) e componenti senza modello 3D
    Dal prof: 4 servo (uno per ruota), batteria LiPo 3S 11,1 V, schede buck
    DC-DC, Arduino Nano; braccio e pinza con STL in arrivo. Nuova scheda
    "L'energia" in anatomia.md (con la sottotensione letta da ViennaMonitor);
    nell'esploso questi componenti compaiono nell'elenco "senza modello 3D".
    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
2026-11-10 Anatomia: foto del robot (10/11) e cosa si vede
    immagini/foto_robot/: sotto, fianchi e davanti (ridotte a 1200 px).
    anatomia.md: nuova sezione 1a con quello che le foto mostrano (servo
    standard per ruota, vano centrale, molle, Raspberry, buck, scheda a 2 relè
    delle luci, tester LiPo, pinza a ingranaggi, strisce LED COB 5 V, camera e
    laser davanti), tutto da confermare con la squadra.
    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
2026-11-10 Anatomia: servo FS5106R, DM996, due PCA9685, 3 buck, LiPo Zeee 2200 mAh
    Dati del prof (10/11): servo delle ruote Feetech FS5106R, braccio DM996
    all metal, due schede a 16 canali (0x41 ruote, 0x40 braccio e pinza),
    3 buck DC-DC, batteria Zeee 3S 2200 mAh 50C 24,4 Wh, camera linea = quella
    verso il basso, arena = quella inclinata. Aggiornati anatomia.md, l'esploso
    (componenti senza modello 3D) e CLAUDE.md.
    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
2026-11-10 Esploso: il braccio (Braccio.stl) con il cursore giù/su
    Braccio.stl dal prof (nome originale 0Servo4WDFisso2006PinzaMonoVaccaro.stl):
    non è nelle coordinate di montaggio ed è disegnato abbassato. Nell'esploso
    il perno (centro del disco per la squadretta del DM996) è messo sul davanti
    a sinistra, in posizione indicativa, e il cursore "Braccio" lo ruota da giù
    (raccolta) a su (circa 140 gradi, come nelle foto). Aggiornati anatomia.md,
    LEGGIMI degli STL e CLAUDE.md.
    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
    [Braccio.stl]
2026-11-10 Componenti in 3D semplificato sul vassoio dell'esploso
    componenti.py costruisce in Meccanica_STL/componenti/ i modelli
    semplificati (misure dei datasheet, valori indicativi) di servo FS5106R,
    DM996, Arduino Nano, PCA9685, buck DC-DC tipo LM2596 e LiPo Zeee 3S 2200:
    fatti da noi, senza problemi di licenza. Nell'esploso stanno su un vassoio
    accanto al robot (4 servo, 3 buck, 2 PCA9685), ognuno con la sua scheda,
    finché non si conferma dove sono montati. Aggiornati SKILL.md, anatomia.md e
    il LEGGIMI degli STL.
    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
    [Arduino_Nano.stl, Buck_DCDC.stl, LiPo_Zeee_3S_2200.stl, PCA9685_16canali.stl, Servo_DM996.stl, Servo_FS5106R.stl]
2026-11-10 Esploso: componenti montati ai tre livelli, più Raspberry Pi 5 e relè
    Dal prof: livello 1 (piastra dei servo, piano Y -41) batteria e buck;
    livello 2 (base della logica, Y +4) le due PCA9685 e l'Arduino; livello 3
    (copertura alta, Y +41) Raspberry e relè. I componenti si smontano con il
    loro livello. Nuovi modelli semplificati: Raspberry Pi 5 e scheda a 2 relè.
    Aggiornati anatomia.md (I tre livelli), SKILL.md, LEGGIMI degli STL e
    CLAUDE.md.
    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
    [Raspberry_Pi_5.stl, Rele_2_canali.stl]
2026-11-10 Simulatore V32: pista della scuola a piastrelle, ponte e tunnel, luci, cono del laser
    - Pista della scuola a piastrelle dalle foto del 10/11 (bozza da correggere): pista_scuola_piastrelle.py,
    mappa con disegna_mappa.py -> mappa_scuola.png. Scenari scuola_nuova e scuola_nuova_buio.
    - Ponte sopra il tunnel su due livelli: rampe 21 gradi (23 cm), tunnel 91 x 30 x 22,3 cm con pareti, tubi.
    Altalena 19,5 gradi.
    - realismo.py: luci e ombre, tunnel buio, strisce LED, verdi di tonalita' diverse (lucidi con riflesso),
    cono del VL53L1X (27 gradi, rumore che cresce con la distanza), fianco che scivola sulle pareti.
    - Corretto arena(palline=..., righe=4) che ignorava le palline date.
    - Le 15 piste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
2026-11-10 Prototipo del terminale nuovo (cabina di pilotaggio): rivede le scatole nere con la grafica proposta
    Solo uno strumento di prova in Strumenti_prove_Claude: il codice del robot non cambia.
    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
2026-11-10 V42: FIX 107 terminale "cabina di pilotaggio" con camere e cronometro
    - ViennaCabina.py (nuovo): laser dall'alto, assetto con storia, cronometro che parte con lo switch e conta le LoP,
    camera linea e camera arena in piccolo, motori e pinza, fasi della gara, eventi.
    - ViennaMonitor.py: TERMINALE = "cabina" (ridisegno 5 volte al secondo); con finestra sotto 100 x 38 torna il pannello.
    - ViennaDataConf.py: VERSIONE V42, TERMINALE, CRONO_DURATA_S, CRONO_NUOVA_GARA_S.
    - Moviola delle scatole nere (Strumenti_prove_Claude/terminale_nuovo.py) con la stessa schermata.
    - Simulatore: 6 gare identiche alla V41 campione per campione. Issue #19.
    C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
    [robot.stl]
2026-11-10 V42: FIX 108 una scatola nera per ogni run, con le LoP dentro; camere della cabina più grandi
    - Spegnere lo switch per meno di 120 s è una LoP: stessa scatola nera, tempo continuo, eventi "STOP n" (com'era il
    robot l'ultimo istante acceso) e "LoP n: si riparte", campo lop nei campioni. File nuovo solo per una gara nuova.
    - Nome dei file invariato (run_AAAA-MM-GG_hh-mm-ss_V<n>.jsonl).
    - Cabina: le camere crescono con la finestra (da 8 a 20 righe).
    - Simulatore identico alla V41 (6 gare campione per campione). Impronta 23983472617a3c07.
    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
    [ViennaCabina.py]
2026-11-10 V43: FIX 108 una scatola nera per ogni run, con le LoP dentro; camere della cabina più grandi
    - Switch spento per meno di 120 s = LoP: stessa scatola nera, tempo continuo, eventi "STOP n" (com'era il robot
    l'ultimo istante acceso) e "LoP n: si riparte", campo lop nei campioni. File nuovo solo per una gara nuova.
    - La V42 (già unita) non è stata toccata. Simulatore identico alla V41 (6 gare). Impronta 166f805b56cee80a.
    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
    [robot.stl]
2026-11-10 README: il motto di Antonio
    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
2026-11-10 Pinza e supporto degli switch nell'esploso 3D (STL del prof, 10/11)
    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
    [BiSwitch.stl, PinzaParteDxSfera.stl, PinzaParteSxSfera.stl]
2026-11-12 avvia.sh eseguibile in tutte le versioni (l'avvio automatico del robot non partiva)
    Cambia solo il permesso del file, non il contenuto: l'impronta del codice (solo i .py) non cambia.
    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
2026-11-12 V44: FIX 109 solo la cabina nel terminale, FIX 110 un solo programma del robot alla volta
    - PANNELLO = False: la finestra STATO non si apre più da sola; con la cabina restano spente anche le finestre OpenCV.
    - In cima a RwdFoto.py, prima di camere, seriale e motori: lucchetto flock; un secondo programma scrive l'avviso ed esce.
    - Simulatore identico alla V43. Impronta a0669f32449f6c26.
    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
    [robot.stl]
2026-11-12 V45: FIX 111 niente ingresso in mezzo alla pista (il laser davanti deve vedere l'arena)
    - ArenaDavanti(): prima di "Verificata entrata", mediana delle letture vere del laser davanti; oltre 150 cm non c'è
    l'arena e l'ingresso si annulla. ARGENTO_DOPO_S (spento) per un tempo minimo dalla partenza della run.
    - Scatola nera 12/11 10:09, 93-103 s: falso argento, laser 166 cm, discesa di 28 gradi. Sui dati veri: 15 ingressi veri
    su 15 entrano, il falso è annullato. Simulatore identico alla V44 (11 gare). Impronta c6bb6bcc58a393e3.
    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
    [robot.stl]
2026-11-12 Raspberry: avvio automatico con l'ultima versione (niente più ln a mano)
    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
